kawel/rgb_sensor_hw/README.md

# rgb_sensor_hw
RGB sensor Kicad project
