kawel/rgb_sensor_hw/sch/rgb_sensor_v2/BOM/rgb_sensor_v2_BOM.ods

 |  |  | PROD qty | 7
Ref | Qnty | Value | Cmp name | Footprint | Description | Supplier |  |  | Order qty
C1, C2, C3, C4, C5, | 5 | 100n | C | Capacitor_SMD:C_0603_1608Metric_Pad1.08x0.95mm_HandSolder | Unpolarized capacitor | TME | CL10B104KO8NNNC (https://www.tme.eu/pl/details/cl10b104ko8nnnc/kondensatory-mlcc-smd-0603/samsung/) |  | 35
D1, D2, D3, D4, D5, D6, D7, D8, D9, D10, | 10 | LED | LED | Diode_SMD:D_0603_1608Metric_Castellated | Light emitting diode | TME | LTW-C193US5 (https://www.tme.eu/pl/details/ltw-c193us5/diody-led-smd-biale/liteon/) |  | 70
J1, | 1 | Conn_01x20_Male | Conn_01x20_Male | Connector_JST:JST_PHD_S20B-PHDSS_2x10_P2.00mm_Horizontal | Generic connector, single row, 01x20, script generated (kicad-library-utils/schlib/autogen/connector/) | TME | DS1014-20MF1B (https://www.tme.eu/pl/details/ds1014-20mf1b/zlacza-idc/connfly/) |  | 7
Q1, Q2, Q3, Q4, Q5, | 5 | 2N7002 | 2N7002 | Package_TO_SOT_SMD:SOT-23 | 0.115A Id, 60V Vds, N-Channel MOSFET, SOT-23 | TME | 2N7002 (https://www.tme.eu/pl/details/2n7002/tranzystory-z-kanalem-n-smd/on-semiconductor/) |  | 35
R1, R2, R6, R7, R11, R12, R16, R17, R21, R22, | 10 | 3k3 | R | Resistor_SMD:R_0603_1608Metric_Pad0.98x0.95mm_HandSolder | Resistor | TME | CRCW06033K30FKTABC (https://www.tme.eu/pl/details/crcw06033k30fktabc/rezystory-smd-0603/vishay/) |  | 70
R3, R4, R8, R9, R13, R14, R18, R19, R23, R24, | 10 | 330 | R | Resistor_SMD:R_0603_1608Metric_Pad0.98x0.95mm_HandSolder | Resistor | TME | ERJ3GEYJ331V (https://www.tme.eu/pl/details/erj3geyj331v/rezystory-smd-0603/panasonic/) |  | 70
R5, R10, R15, R20, R25, | 5 | 10k | R | Resistor_SMD:R_0603_1608Metric_Pad0.98x0.95mm_HandSolder | Resistor | tme | CRCW060310K0FKTABC (https://www.tme.eu/pl/details/crcw060310k0fktabc/rezystory-smd-0603/vishay/) |  | 35
U1, U2, U3, U4, U5, | 5 | TCS34725FN | TCS34725FN-TCS-rgb_sensor_v2-rescue | AMS_TCS34725FN:AMS-TCS34725FN-MFG |  | RS | 102-4173 |  | 35
 | 1 |  |  |  | Wtyk; IDC; żeńskie; PIN: 20; z dociskiem przewodu; IDC; na taśmę | TME | T826120A201CEU (https://www.tme.eu/pl/details/t826120a201ceu/zlacza-idc/amphenol/) | T826120A101CEU (https://www.tme.eu/pl/details/t826120a101ceu/zlacza-idc/amphenol/) | 7
 |  |  |  |  |  | 1 |  |  |  | Column1 | Column2 | Column1 | Column2
 |  |  |  |  |  | 2 |  |  |  | 06035A470JAT2A AVX | 24 | 06035A470JAT2A AVX | 24
 |  |  |  |  |  | 3 |  |  |  | 102-4173 | 35 | 102-4173 | 35
 |  |  |  |  |  | 4 |  |  |  | 20021221-00010C4LF | 8 | 20021221-00010C4LF | 8
 |  |  |  |  |  | 5 |  |  |  | 2N7002 | 35 | 2N7002 | 35
 |  |  |  |  |  | 6 |  |  |  | ABM3B-8.000MHZ-10 | 8 | ABM3B-8.000MHZ-10 | 8
 |  |  |  |  |  | 7 |  |  |  | BLM18AG102SH1D | 8 | BLM18AG102SH1D | 8
 |  |  |  |  |  | 8 |  |  |  | CL10B103KB8NNNC | 8 | CL10B103KB8NNNC | 8
 |  |  |  |  |  | 9 |  |  |  | CL10B104KO8NNNC | 99 | CL10B104KO8NNNC | 35
 |  |  |  |  |  |  |  |  |  |  |  | CL10B104KO8NNNC | 64
 |  |  |  |  |  |  |  |  |  | CL10C100JB8NNNC | 16 | CL10C100JB8NNNC | 16
 |  |  |  |  |  |  |  |  |  | CRCW060310K0FKTABC | 59 | CRCW060310K0FKTABC | 35
 |  |  |  |  |  |  |  |  |  |  |  | CRCW060310K0FKTABC | 24
 |  |  |  |  |  |  |  |  |  | CRCW06031M00FKEA | 8 | CRCW06031M00FKEA | 8
 |  |  |  |  |  |  |  |  |  | CRCW06033K30FKTABC | 70 | CRCW06033K30FKTABC | 70
 |  |  |  |  |  |  |  |  |  | DS1014-20MF1B | 15 | DS1014-20MF1B | 7
 |  |  |  |  |  |  |  |  |  |  |  | DS1014-20MF1B | 8
 |  |  |  |  |  |  |  |  |  | ERJ3GEYJ331V | 70 | ERJ3GEYJ331V | 70
 |  |  |  |  |  |  |  |  |  | FT230XS-R | 8 | FT230XS-R | 8
 |  |  |  |  |  |  |  |  |  | LTW-C193US5 | 70 | LTW-C193US5 | 70
 |  |  |  |  |  |  |  |  |  | MX-47346-0001 | 8 | MX-47346-0001 | 8
 |  |  |  |  |  |  |  |  |  | RC0J476M05005VR | 8 | RC0J476M05005VR | 8
 |  |  |  |  |  |  |  |  |  | SC1C106M04005VR | 8 | SC1C106M04005VR | 8
 |  |  |  |  |  |  |  |  |  | SMD0603-27R | 32 | SMD0603-27R | 32
 |  |  |  |  |  |  |  |  |  | STM32F030K6T6 | 8 | STM32F030K6T6 | 8
 |  |  |  |  |  |  |  |  |  | T826120A201CEU | 15 | T826120A201CEU | 7
 |  |  |  |  |  |  |  |  |  |  |  | T826120A201CEU | 8
 |  |  |  |  |  |  |  |  |  | TLV1117-33CDCYG3 | 8 | TLV1117-33CDCYG3 | 8
