kawel/rgb_sensor_hw/_release/mech/rgb_sensor_housing/google_final2.stl

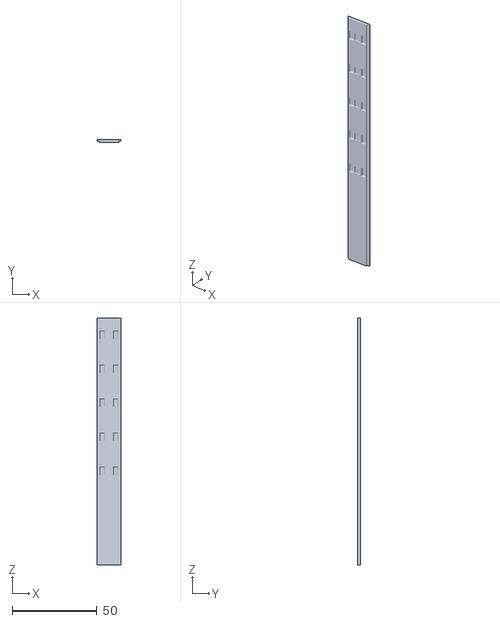
[picture p1: CAD file, 2021-03-05]
_release/mech/rgb_sensor_housing/google_final2.stl
14.4 x 1.62 x 145.5
