kawel/rgb_sensor_hw/case/rgb_sens_ctrl_bottom.2.stl

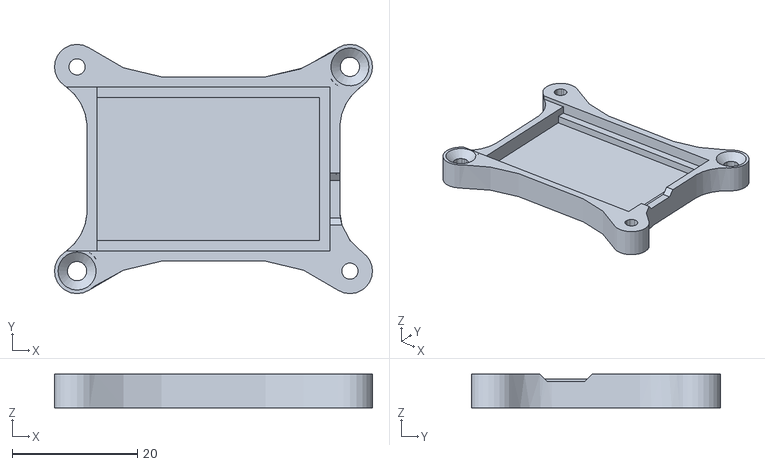
[picture p2: CAD file, 2021-03-05]
case/rgb_sens_ctrl_bottom.2.stl
50.8 x 39.8 x 5.36
