kawel/rgb_sensor_hw/parts/IC_AMS_TCS34725FN/eec.models/AMS_-_TCS34725FN.step

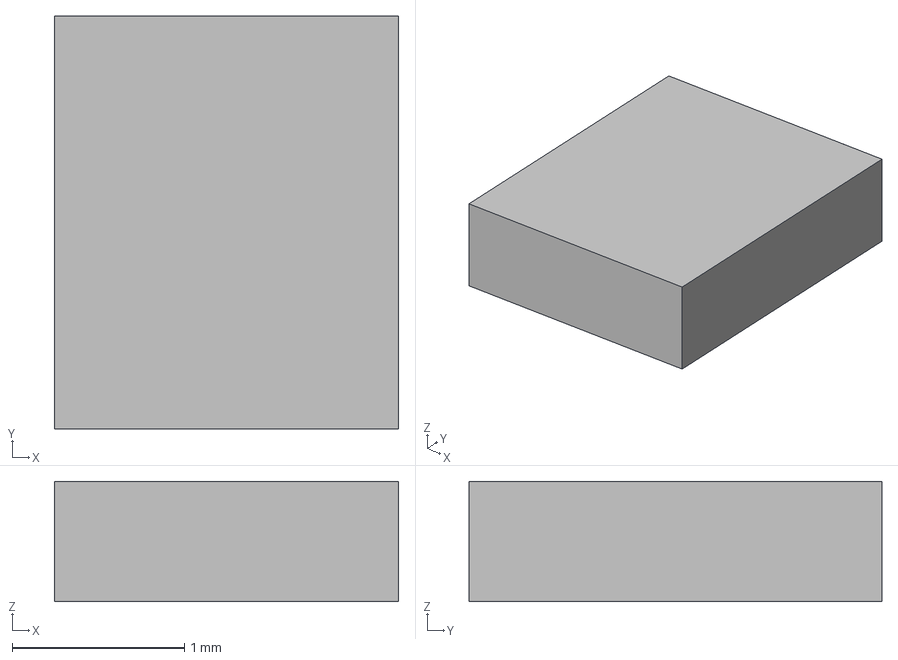
[picture p3: CAD file, 2020-11-04]
parts/IC_AMS_TCS34725FN/eec.models/AMS_-_TCS34725FN.step
2.00 x 2.40 x 0.7 mm
