kawel/rgb_sensor_hw/_release/mech/rgb_sensor_housing/support_rgb_final_all1.3mf

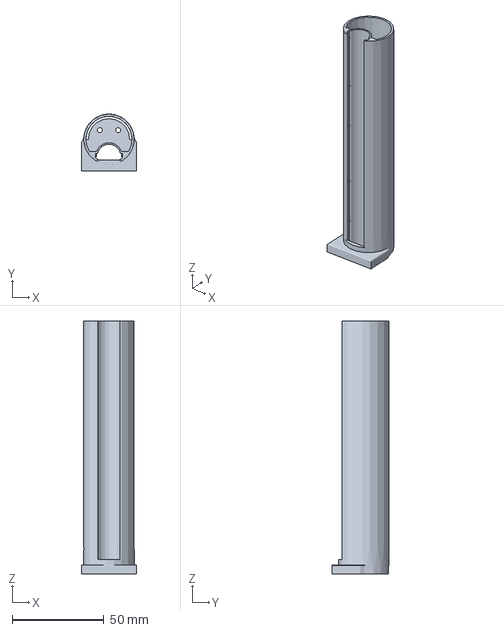
[picture p4: CAD file, 2021-03-05]
_release/mech/rgb_sensor_housing/support_rgb_final_all1.3mf
30.2 x 31.1 x 138.0 mm
