kawel/rgb_sensor_hw/case/rgb_sens_ctrl_top.21.stl

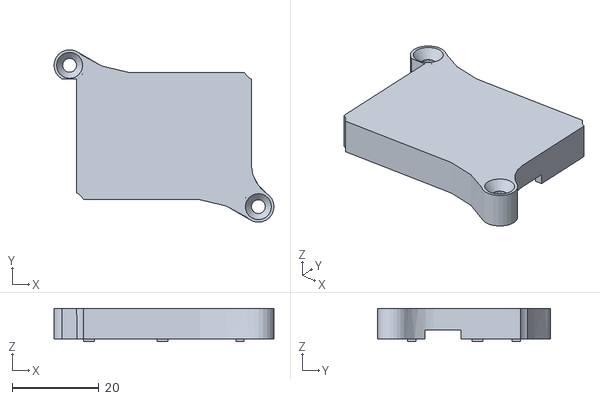
[picture p5: CAD file, 2021-03-05]
case/rgb_sens_ctrl_top.21.stl
50.8 x 39.8 x 7.70
