kawel/rgb_sensor_hw/_release/mech/rgb_sensor_housing/cap_final.3mf

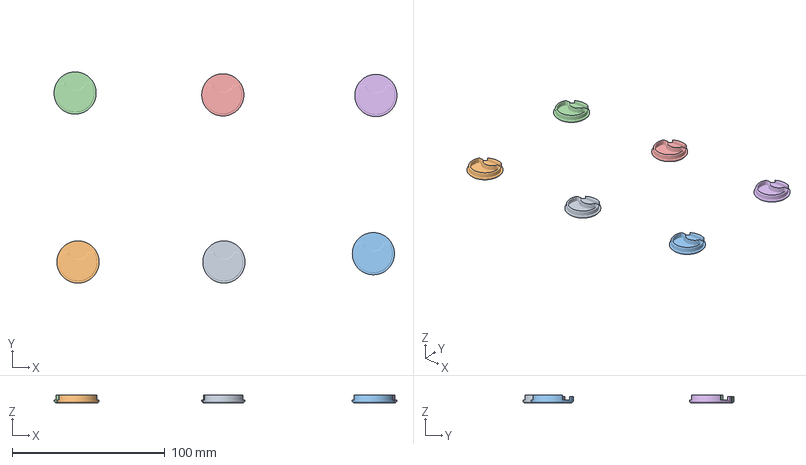
[picture p6: CAD file, 2021-03-05]
_release/mech/rgb_sensor_housing/cap_final.3mf
224.2 x 138.0 x 5.50 mm
cap_final1.stl
cap_final2.stl
cap_final3.stl
cap_final4.stl
cap_final5.stl
cap_final6.stl
