kawel/rgb_sensor_hw/_release/mech/rgb_sensor_housing/cap_bot_final_all6.3mf

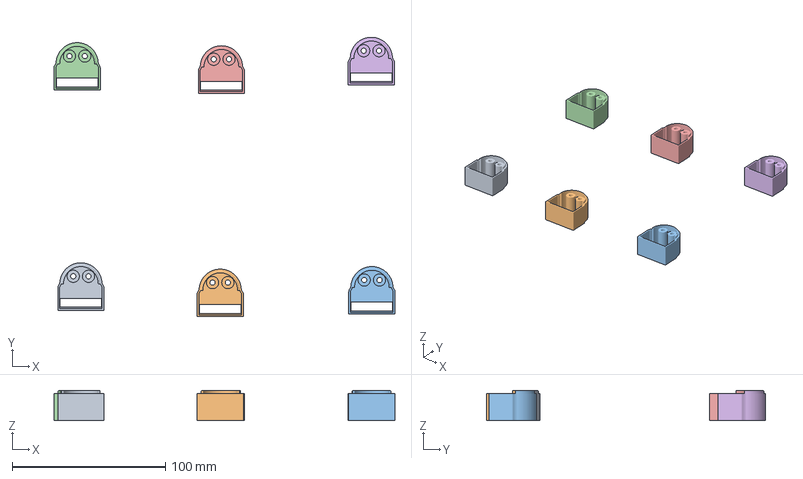
[picture p7: CAD file, 2021-03-05]
_release/mech/rgb_sensor_housing/cap_bot_final_all6.3mf
222.7 x 182.5 x 19.6 mm
cap_bot_final1.stl
cap_bot_final2.stl
cap_bot_final3.stl
cap_bot_final4.stl
cap_bot_final5.stl
cap_bot_final6.stl
