kawel/rgb_sensor_hw/case/rgb_sens_ctrl_t.2.3mf

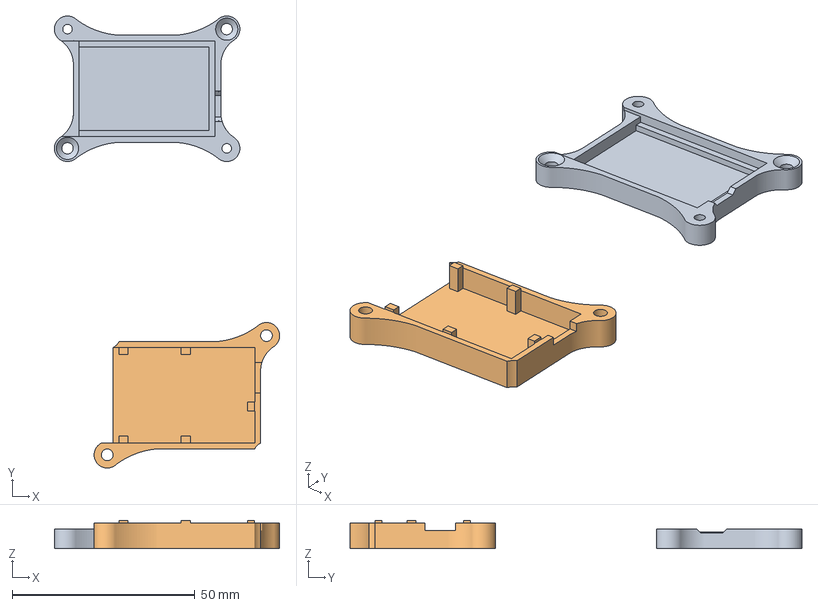
[picture p8: CAD file, 2021-03-05]
case/rgb_sens_ctrl_t.2.3mf
61.6 x 123.6 x 7.70 mm
rgb_sens_ctrl_t.2.stl
rgb_sens_ctrl_b.2.stl
