kawel/rgb_sensor_hw/_release/mech/rgb_sensor_housing/support_rgb_final_all3.3mf

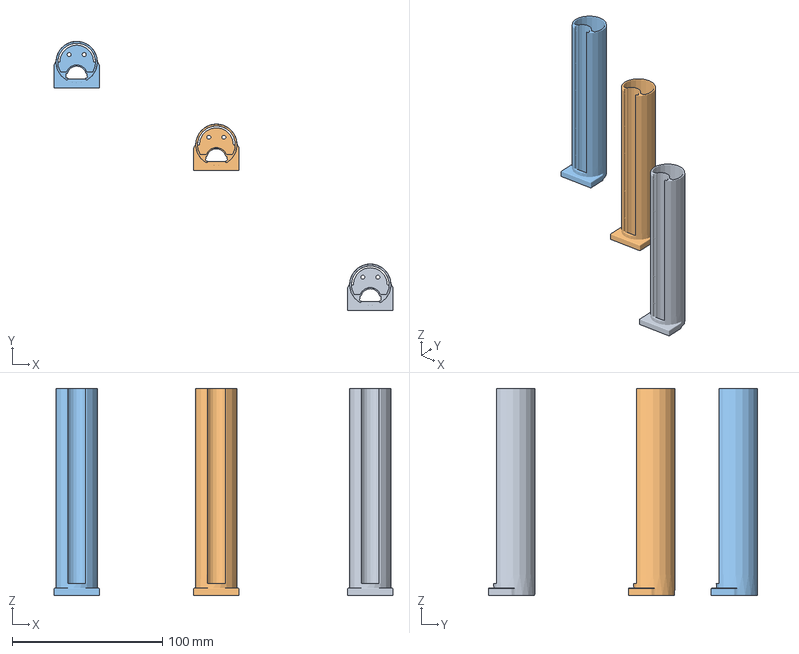
[picture p9: CAD file, 2021-03-05]
_release/mech/rgb_sensor_housing/support_rgb_final_all3.3mf
225.6 x 179.3 x 138.0 mm
support_rgb_final1.stl
support_rgb_final2.stl
support_rgb_final3.stl
