kawel/rgb_sensor_hw/_release/mech/rgb_sensor_housing/google_final_all3.3mf

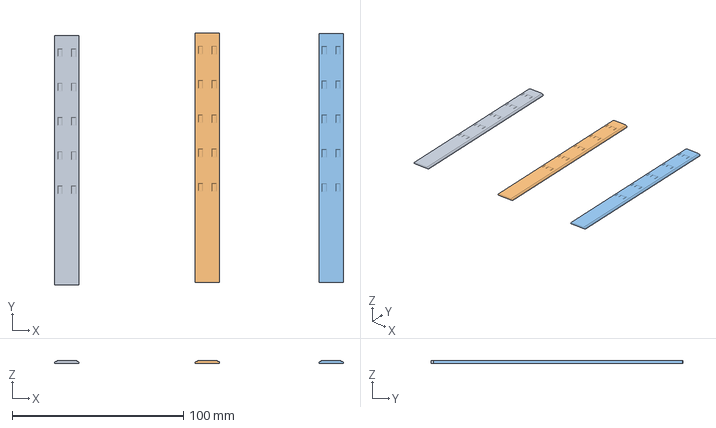
[picture p10: CAD file, 2021-03-05]
_release/mech/rgb_sensor_housing/google_final_all3.3mf
168.6 x 147.0 x 1.62 mm
google_final.stl x 3
