kawel/rgb_sensor_hw/_release/mech/rgb_sensor_housing/google_final2_all3.3mf

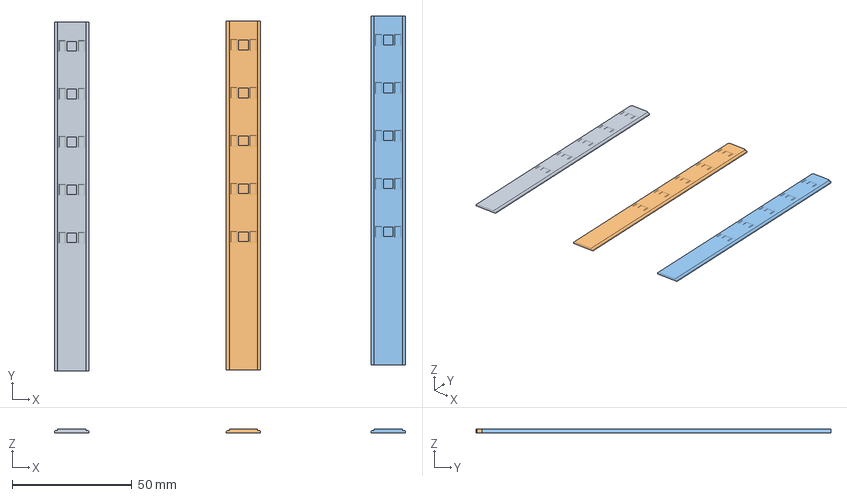
[picture p11: CAD file, 2021-03-05]
_release/mech/rgb_sensor_housing/google_final2_all3.3mf
146.4 x 148.0 x 1.62 mm
google_final2.stl x 3
