kawel/rgb_sensor_hw/_release/mech/rgb_sensor_housing/cap_bot_final.stl

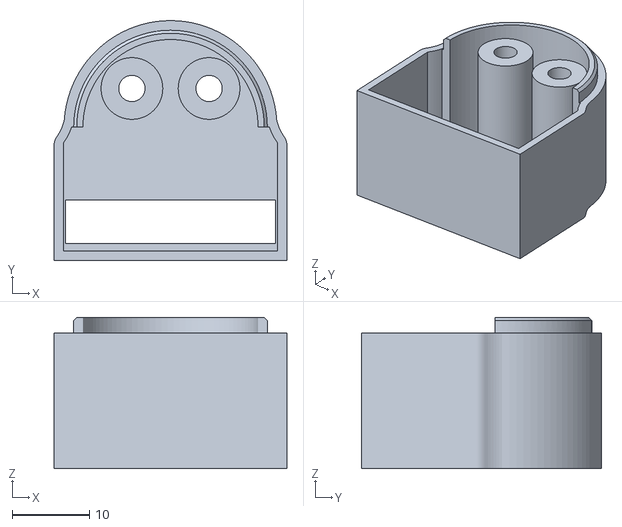
[picture p12: CAD file, 2021-03-05]
_release/mech/rgb_sensor_housing/cap_bot_final.stl
30.2 x 31.1 x 19.6
