kawel/rgb_sensor_hw/_release/mech/rgb_sensor_housing/missing block.3mf

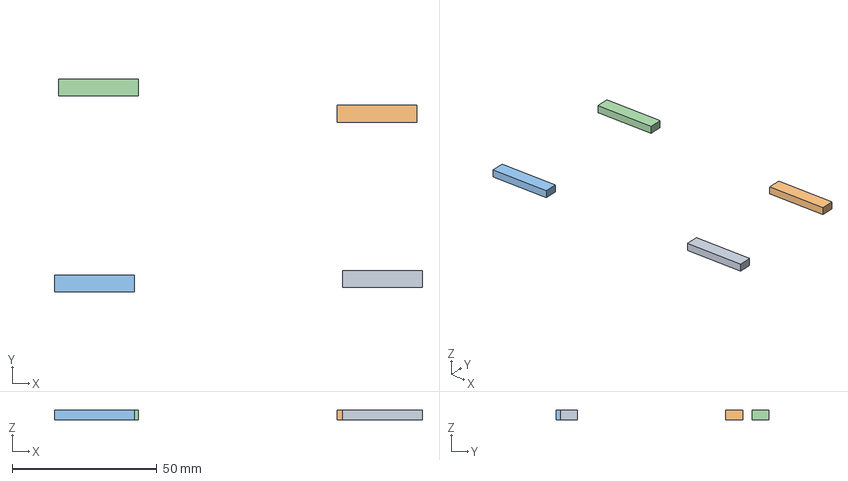
[picture p13: CAD file, 2021-03-05]
_release/mech/rgb_sensor_housing/missing block.3mf
127.1 x 73.7 x 3.30 mm
missing block.stl x 4
