kawel/rgb_sensor_hw/(list of files, cad)

Other CAD files:
case/rgb_sens_ctrl_top.2.stl
case/rgb_sens_ctrl_b.2.stl
_release/mech/rgb_sensor_housing/support_rgb_final.stl
_release/mech/rgb_sensor_housing/google_final.stl
_release/mech/rgb_sensor_housing/support_rgb_final2.stl
_release/mech/rgb_sensor_housing/cap_final.stl
_release/mech/rgb_sensor_housing/missing block - Copy.stl
_release/mech/rgb_sensor_housing/missing block.stl
case/rgb_sens_ctrl_t.2.stl
