kawel/rgb_sensor_hw/sch/rgb_ctrl_board/rgb_ctrl_board/rgb_ctrl_board.kicad_pcb

## KiCad design sch/rgb_ctrl_board/rgb_ctrl_board/rgb_ctrl_board.kicad_pcb (2020-11-16)

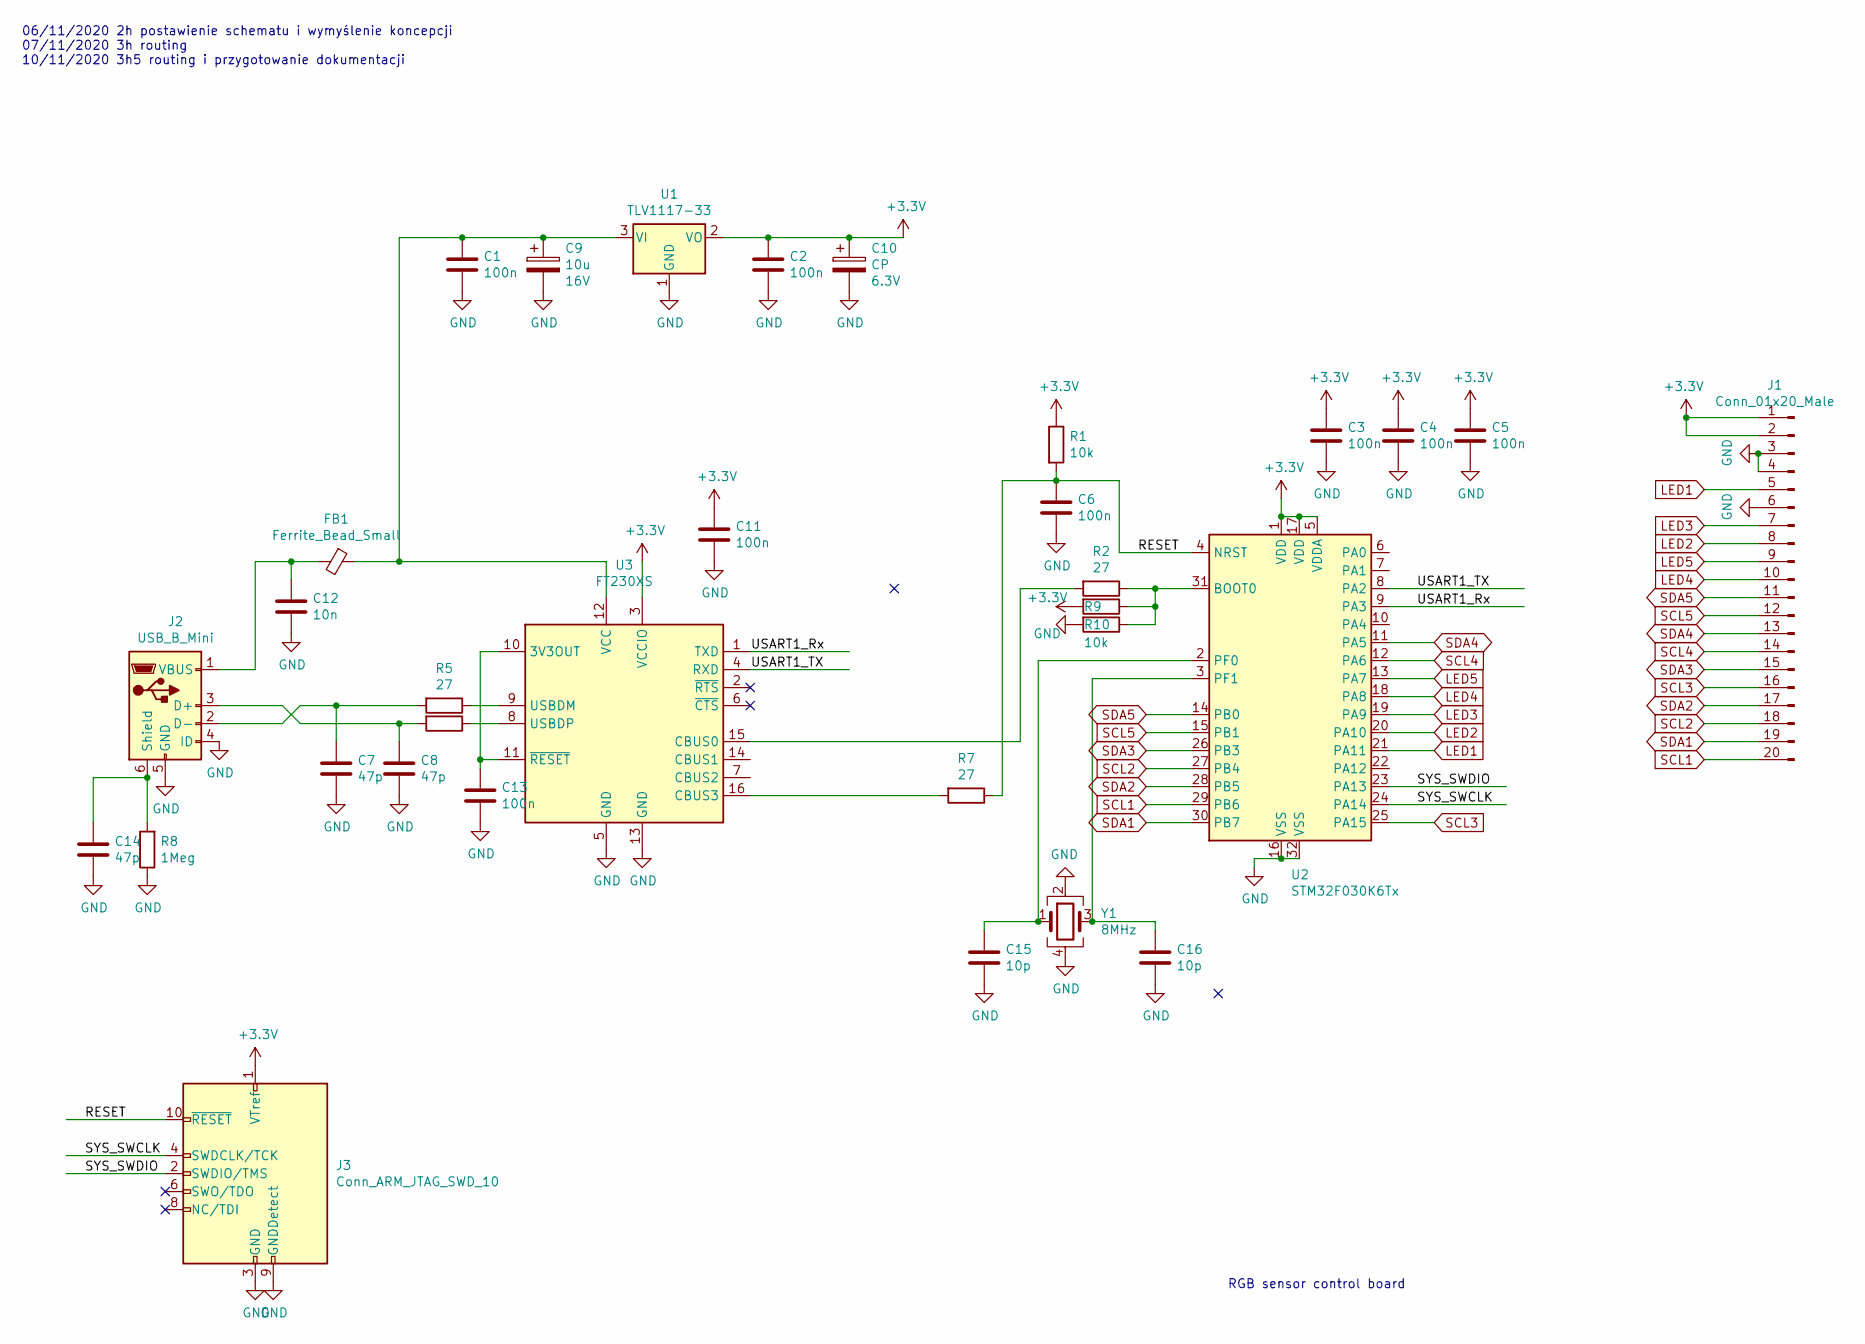
[picture p14: schematic rgb_ctrl_board.sch]

Parts:
C1, C2, C3, C4, C5, C6, C11, C13: 100n; C_0603_1608Metric_Pad1.08x0.95mm_HandSolder
C7, C8, C14: 47p; C_0603_1608Metric_Pad1.08x0.95mm_HandSolder
C9: 10u; C_Elec_4x5.4; Voltage 16V
C10: CP; C_Elec_5x5.4; Voltage 6.3V
C12: 10n; C_0603_1608Metric_Pad1.08x0.95mm_HandSolder
C15, C16: 10p; C_0603_1608Metric_Pad1.08x0.95mm_HandSolder
FB1: Ferrite_Bead_Small; L_0603_1608Metric_Pad1.05x0.95mm_HandSolder
J1: Conn_01x20_Male; JST_PHD_S20B-PHDSS_2x10_P2.00mm_Horizontal
J2: USB_B_Mini; USB_Micro-B_Molex_47346-0001
J3: Conn_ARM_JTAG_SWD_10; PinHeader_2x05_P1.27mm_Vertical
R1, R9, R10: 10k; R_0603_1608Metric_Pad0.98x0.95mm_HandSolder
R2, R5, R6, R7: 27; R_0603_1608Metric_Pad0.98x0.95mm_HandSolder
R8: 1Meg; R_0603_1608Metric_Pad0.98x0.95mm_HandSolder
U1: TLV1117-33; SOT-223-3_TabPin2
U2: STM32F030K6Tx; LQFP-32_7x7mm_P0.8mm
U3: FT230XS; SSOP-16_3.9x4.9mm_P0.635mm
Y1: 8MHz; Oscillator_SMD_TXC_7C-4Pin_5.0x3.2mm_HandSoldering

Connections:
+3V3: C2.1, C3.1, C4.1, C5.1, C10.1, C11.1, J1.1, J1.2, J3.1 (VTref), R1.1, R9.2, U1.2 (VO), U2.1 (VDD), U2.5 (VDDA), U2.17 (VDD), U3.3 (VCCIO)
/RESET: C6.1, J3.10 (~RESET~), R1.2, R7.1, U2.4 (NRST)
/SYS_SWCLK: J3.4 (SWDCLK/TCK), U2.24 (PA14)
/SYS_SWDIO: J3.2 (SWDIO/TMS), U2.23 (PA13)
/USART1_Rx: U2.9 (PA3), U3.1 (TXD)
/USART1_TX: U2.8 (PA2), U3.4 (RXD)
GND: C1.2, C2.2, C3.2, C4.2, C5.2, C6.2, C7.2, C8.2, C9.2, C10.2, C11.2, C12.2, C13.2, C14.2, C15.2, C16.2, J1.3, J1.4, J1.6, J2.4 (ID), J2.5 (GND), J3.3 (GND), J3.5 (GND), J3.9 (GNDDetect), R8.1, R10.2, U1.1 (GND), U2.16 (VSS), U2.32 (VSS), U3.5 (GND), U3.13 (GND), Y1.2, Y1.4
LED1: J1.5, U2.21 (PA11)
LED2: J1.8, U2.20 (PA10)
LED3: J1.7, U2.19 (PA9)
LED4: J1.10, U2.18 (PA8)
LED5: J1.9, U2.13 (PA7)
unnamed: C1.1, C9.1, FB1.1, U1.3 (VI), U3.12 (VCC)
unnamed: C7.1, J2.2 (D-), R5.2
unnamed: C8.1, J2.3 (D+), R6.2
unnamed: C12.1, FB1.2, J2.1 (VBUS)
unnamed: C13.1, U3.10 (3V3OUT), U3.11 (~RESET)
unnamed: C14.1, J2.6 (Shield), R8.2
unnamed: C15.1, U2.2 (PF0), Y1.1
unnamed: C16.1, U2.3 (PF1), Y1.3
unnamed: R2.2, U3.15 (CBUS0)
unnamed: R5.1, U3.9 (USBDM)
unnamed: R6.1, U3.8 (USBDP)
unnamed: R7.2, U3.16 (CBUS3)
unnamed: R2.1, R9.1, R10.1, U2.31 (BOOT0)
SCL1: J1.20, U2.29 (PB6)
SCL2: J1.18, U2.27 (PB4)
SCL3: J1.16, U2.25 (PA15)
SCL4: J1.14, U2.12 (PA6)
SCL5: J1.12, U2.15 (PB1)
SDA1: J1.19, U2.30 (PB7)
SDA2: J1.17, U2.28 (PB5)
SDA3: J1.15, U2.26 (PB3)
SDA4: J1.13, U2.11 (PA5)
SDA5: J1.11, U2.14 (PB0)

Notes on the sheet:
06/11/2020 2h postawienie schematu i wymyślenie koncepcji 07/11/2020 3h routing 10/11/2020 3h5 routing i przygotowanie dokumentacji
RGB sensor control board

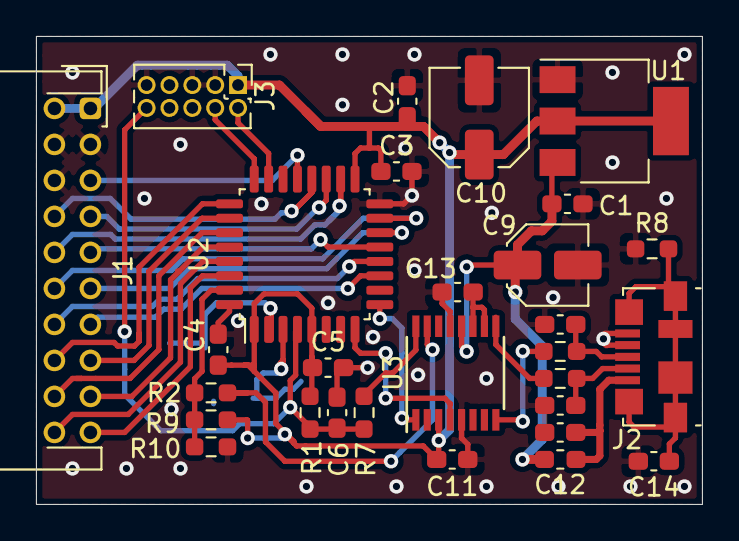
[picture p15: board rgb_ctrl_board.kicad_pcb from above]

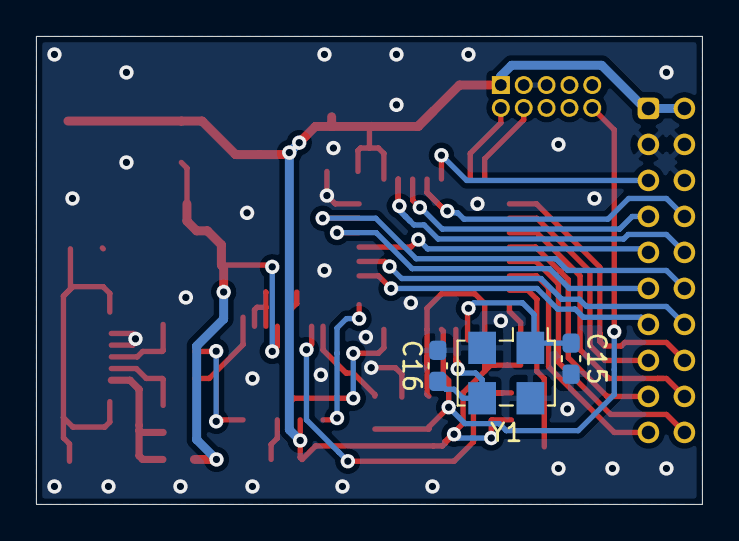
[picture p16: board rgb_ctrl_board.kicad_pcb from below]

Board: 2 copper layers, 37.0 x 26.0 mm, 32 parts (3 on the bottom side), 35 nets.
