kawel/rgb_sensor_hw/sch/rgb_sensor_v2/rgb_sensor_v2.kicad_pcb

## KiCad design sch/rgb_sensor_v2/rgb_sensor_v2.kicad_pcb (2020-11-16)

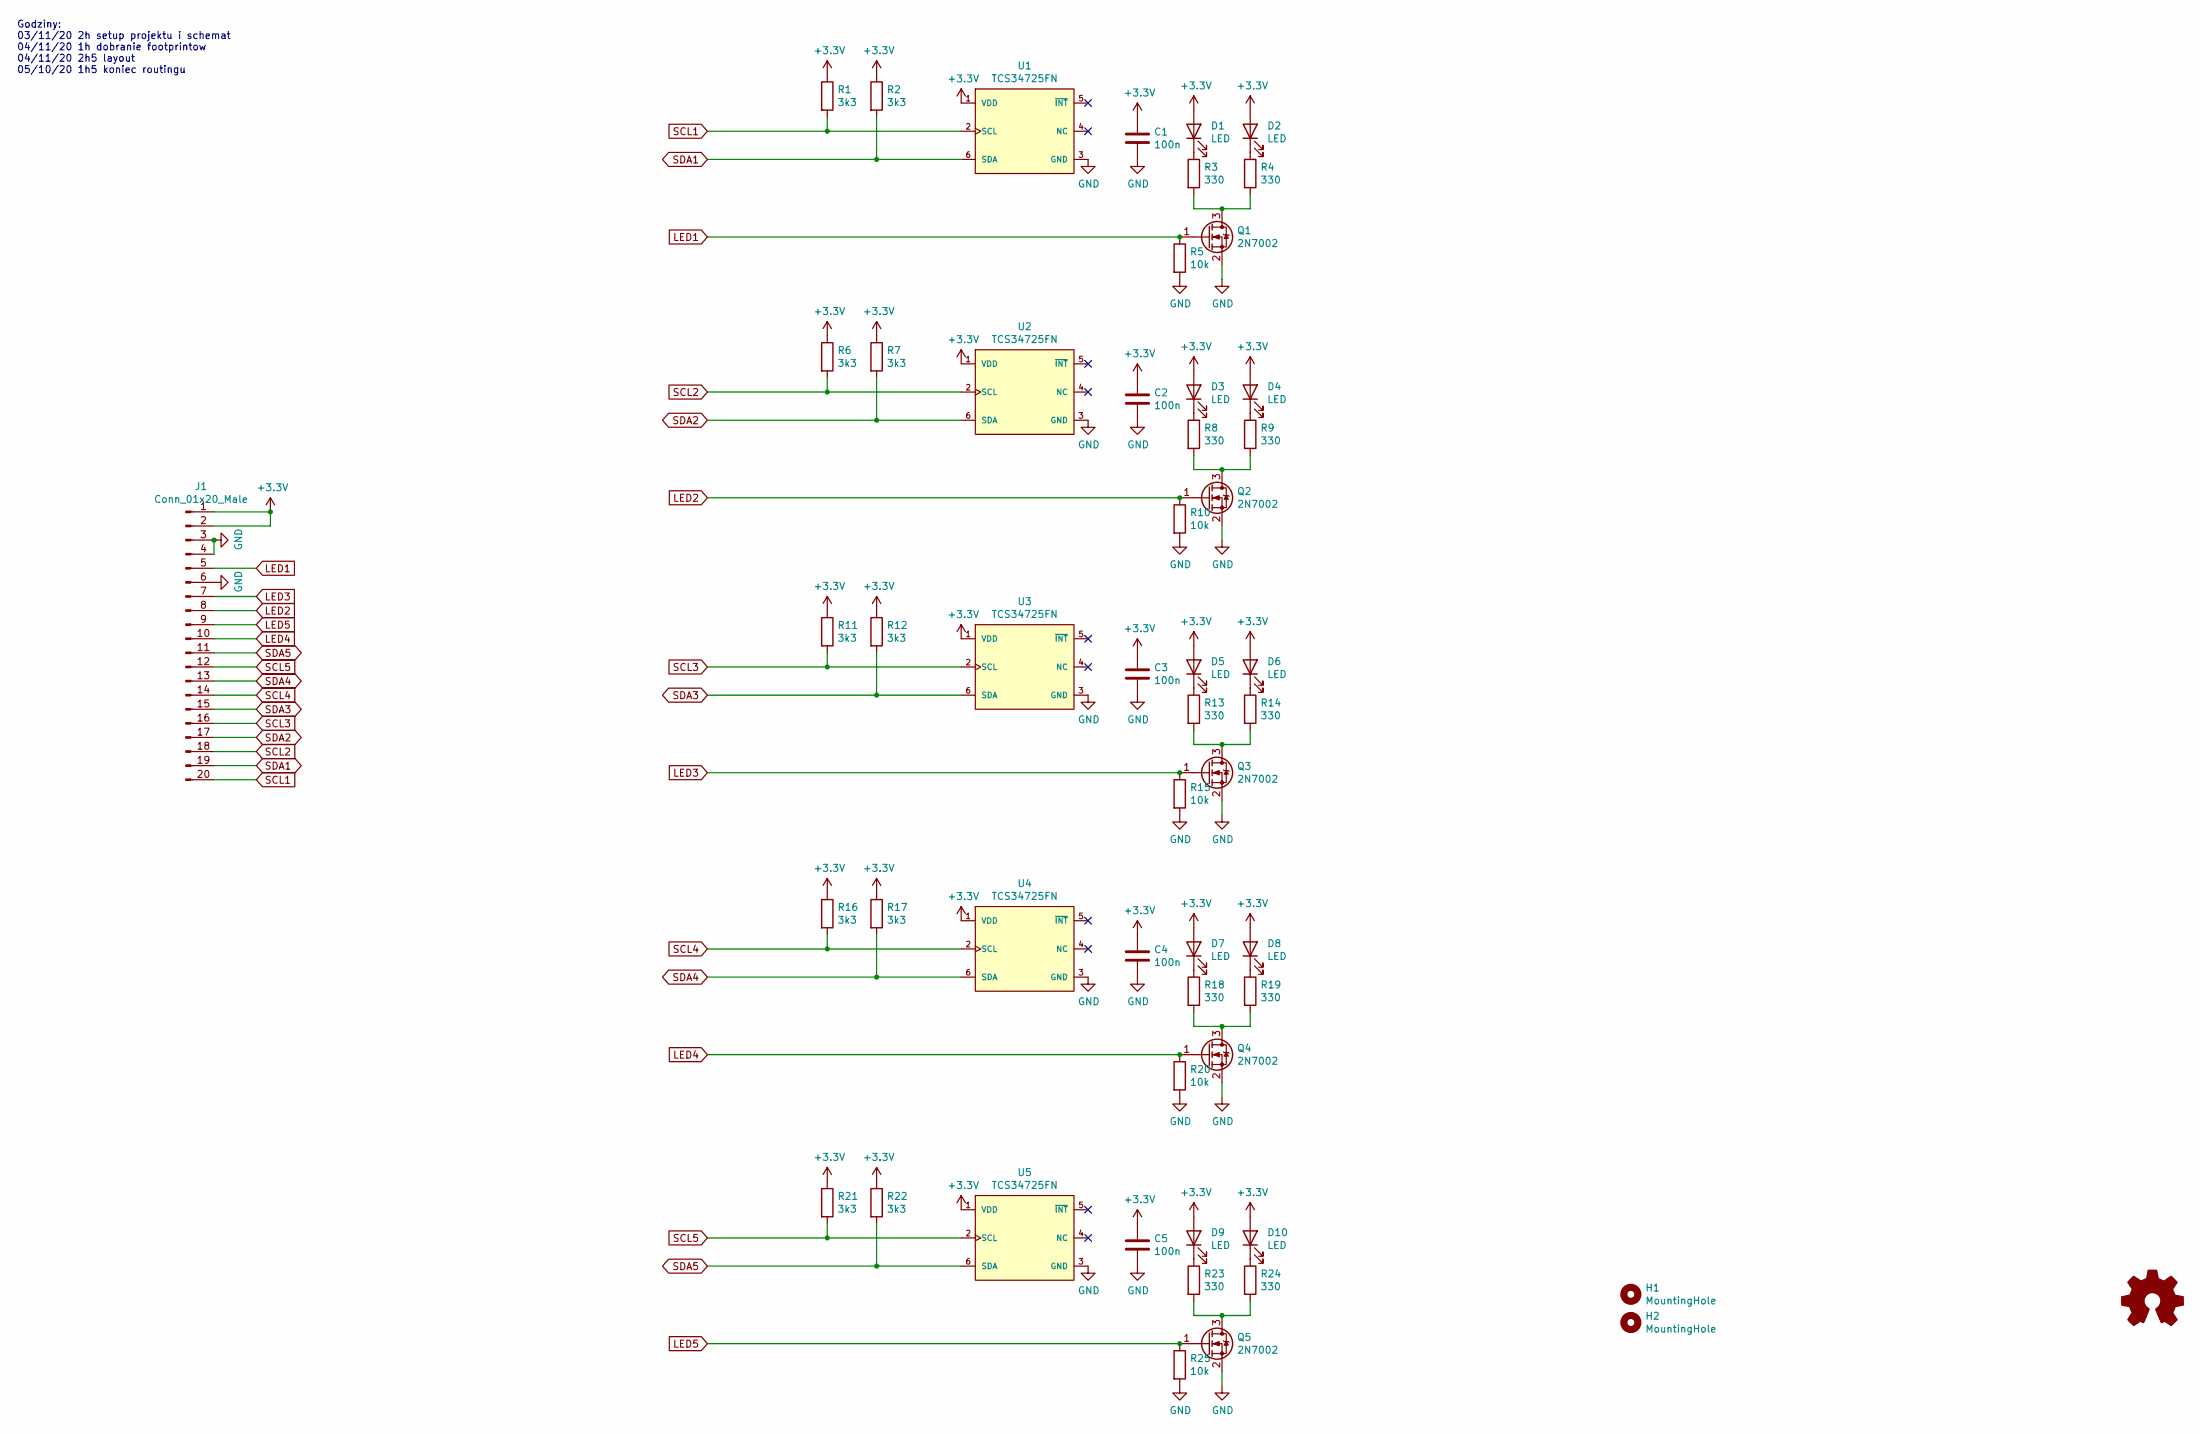
[picture p17: schematic rgb_sensor_v2.sch]

Parts:
C1, C2, C3, C4, C5: 100n; C_0603_1608Metric_Pad1.08x0.95mm_HandSolder
D1, D2, D3, D4, D5, D6, D7, D8, D9, D10: LED; D_0603_1608Metric_Castellated
H1, H2: MountingHole; MountingHole_2.2mm_M2_DIN965_Pad
J1: Conn_01x20_Male; JST_PHD_S20B-PHDSS_2x10_P2.00mm_Horizontal
Q1, Q2, Q3, Q4, Q5: 2N7002; SOT-23
R1, R2, R6, R7, R11, R12, R16, R17, R21, R22: 3k3; R_0603_1608Metric_Pad0.98x0.95mm_HandSolder
R3, R4, R8, R9, R13, R14, R18, R19, R23, R24: 330; R_0603_1608Metric_Pad0.98x0.95mm_HandSolder
R5, R10, R15, R20, R25: 10k; R_0603_1608Metric_Pad0.98x0.95mm_HandSolder
U1, U2, U3, U4, U5: TCS34725FN; AMS-TCS34725FN-MFG; mouser part number 985-TCS34725FN; digikey description IC COLOR CONV LIGHT-DGTL 6-DFN

Connections:
+3V3: C1.1, C2.1, C3.1, C4.1, C5.1, D1.2 (A), D2.2 (A), D3.2 (A), D4.2 (A), D5.2 (A), D6.2 (A), D7.2 (A), D8.2 (A), D9.2 (A), D10.2 (A), J1.1, J1.2, R1.1, R2.1, R6.1, R7.1, R11.1, R12.1, R16.1, R17.1, R21.1, R22.1, U1.1 (VDD), U2.1 (VDD), U3.1 (VDD), U4.1 (VDD), U5.1 (VDD)
GND: C1.2, C2.2, C3.2, C4.2, C5.2, J1.3, J1.4, J1.6, Q1.2 (S), Q2.2 (S), Q3.2 (S), Q4.2 (S), Q5.2 (S), R5.2, R10.2, R15.2, R20.2, R25.2, U1.3 (GND), U2.3 (GND), U3.3 (GND), U4.3 (GND), U5.3 (GND)
LED1: J1.5, Q1.1 (G), R5.1
LED2: J1.8, Q2.1 (G), R10.1
LED3: J1.7, Q3.1 (G), R15.1
LED4: J1.10, Q4.1 (G), R20.1
LED5: J1.9, Q5.1 (G), R25.1
unnamed: D1.1 (K), R3.1
unnamed: D2.1 (K), R4.1
unnamed: D3.1 (K), R8.1
unnamed: D4.1 (K), R9.1
unnamed: D5.1 (K), R13.1
unnamed: D6.1 (K), R14.1
unnamed: D7.1 (K), R18.1
unnamed: D8.1 (K), R19.1
unnamed: D9.1 (K), R23.1
unnamed: D10.1 (K), R24.1
unnamed: Q1.3 (D), R3.2, R4.2
unnamed: Q2.3 (D), R8.2, R9.2
unnamed: Q3.3 (D), R13.2, R14.2
unnamed: Q4.3 (D), R18.2, R19.2
unnamed: Q5.3 (D), R23.2, R24.2
SCL1: J1.20, R1.2, U1.2 (SCL)
SCL2: J1.18, R6.2, U2.2 (SCL)
SCL3: J1.16, R11.2, U3.2 (SCL)
SCL4: J1.14, R16.2, U4.2 (SCL)
SCL5: J1.12, R21.2, U5.2 (SCL)
SDA1: J1.19, R2.2, U1.6 (SDA)
SDA2: J1.17, R7.2, U2.6 (SDA)
SDA3: J1.15, R12.2, U3.6 (SDA)
SDA4: J1.13, R17.2, U4.6 (SDA)
SDA5: J1.11, R22.2, U5.6 (SDA)

Notes on the sheet:
Godziny: 03/11/20 2h setup projektu i schemat 04/11/20 1h dobranie footprintow 04/11/20 2h5 layout 05/10/20 1h5 koniec routingu

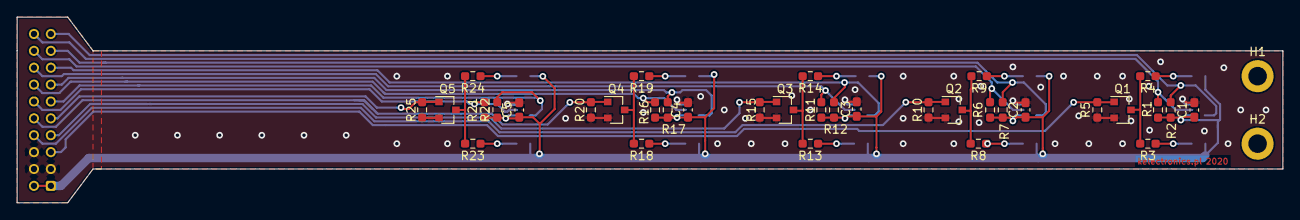
[picture p18: board rgb_sensor_v2.kicad_pcb from above]

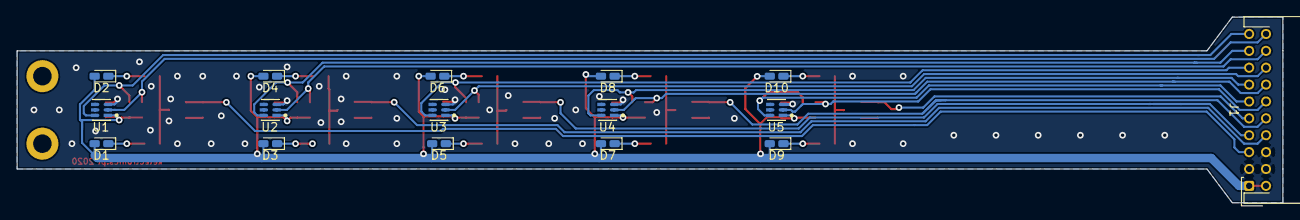
[picture p19: board rgb_sensor_v2.kicad_pcb from below]

Board: 2 copper layers, 150.0 x 22.0 mm, 53 parts (16 on the bottom side), 32 nets.
