kawel/rgb_sensor_hw/_release/mech/rgb_sensor_housing/g-code/3D_print_time.txt

cap_bot 3h 20m
cap 1h
google 2x 1h 55m
support 2x 7h 10m
missing block 1h

--------------
23.5h
