kawel/rgb_sensor_hw/stm32f030k6tx/stm32f030k6tx.ioc

Mcu.UserName=STM32F030K6Tx
PA10.Signal=S_TIM1_CH3
PA11.Signal=S_TIM1_CH4
PA13.Signal=SYS_SWDIO
PA14.Signal=SYS_SWCLK
PA15.Signal=GPIO_Output
PA2.Signal=USART1_TX
PA3.Signal=USART1_RX
PA5.Signal=GPIO_Output
PA6.Signal=GPIO_Input
PA7.Signal=S_TIM3_CH2
PA8.Signal=S_TIM1_CH1
PA9.Signal=S_TIM1_CH2
PB0.Signal=GPIO_Output
PB1.Signal=GPIO_Input
PB3.Signal=GPIO_Input
PB4.Signal=GPIO_Output
PB5.Signal=GPIO_Input
PB6.Signal=GPIO_Input
PB7.Signal=GPIO_Output
