kawel/rgb_sensor_hw/(commit log)

2020-11-04 init commit
    Schematics ready
    [AMS_-_TCS34725FN.step, ch1.sch, rgb_sensor_v2.kicad_pcb, rgb_sensor_v2.sch]
2020-11-04 some layout done
    beefore changing pin assignment on main connector
    [rgb_sensor_v2.kicad_pcb, rgb_sensor_v2.sch]
2020-11-04 zrobiony routing ścieżek
    [rgb_sensor_v2.kicad_pcb]
2020-11-05 Zapisany postęp godzinowy
    [rgb_sensor_v2.kicad_pcb, rgb_sensor_v2.sch]
2020-11-05 Pullus routed
    [rgb_sensor_v2.kicad_pcb]
2020-11-06 add fab outputs but those are not gerber
    [rgb_sensor_v2.kicad_pcb, rgb_sensor_v2.sch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]
2020-11-09 dodana plytka ctrl i zrobiony routing w 90%
    [rgb_ctrl_board.kicad_pcb, rgb_ctrl_board.sch, rgb_sensor_v2.kicad_pcb, rgb_sensor_v2.sch]
2020-11-10 skończony routing ctrl
    [rgb_ctrl_board.kicad_pcb, rgb_ctrl_board.sch]
2020-11-10 drobne poprawki
    [rgb_ctrl_board.kicad_pcb]
2020-11-16 add gerber files
    [ch1.sch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]
2020-11-17 Add boms
    1h30m
    [rgb_ctrl_board_BOM.ods, rgb_sensor_v2_BOM.ods]
2021-03-05 add mechanics
    [473460001.stp, rgb_sens_ctrl_b.2.stl, rgb_sens_ctrl_bottom.2.stl, rgb_sens_ctrl_t.2.3mf, rgb_sens_ctrl_t.2.stl, rgb_sens_ctrl_top.2.stl, rgb_sens_ctrl_top.21.stl]
